ZahinTasnim/PTT_Cuffless_BP_Monitor/docs/workflow_flowchart.png

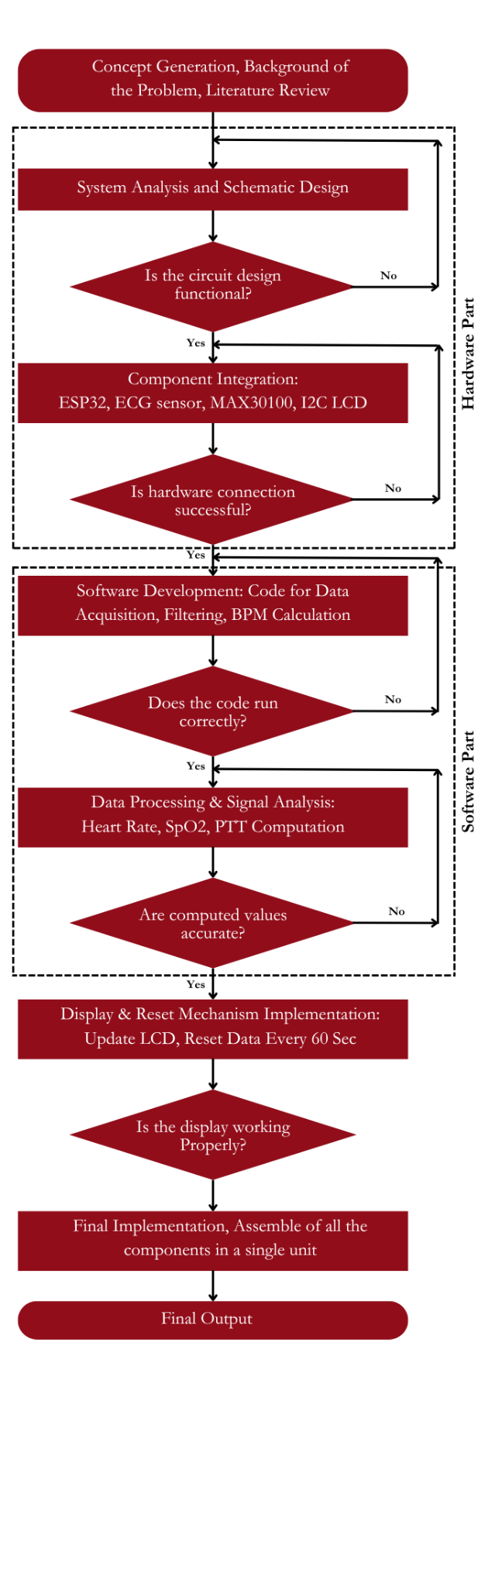
docs/workflow_flowchart.png
