ZahinTasnim/PTT_Cuffless_BP_Monitor/validation/data/subjects_info.csv

record | activity | gender | height | weight | age | bp_sys_start | bp_sys_end | bp_dia_start | bp_dia_end | hr_1_start | hr_1_end | hr_2_start | hr_2_end | spo2_start | spo2_end
s10_run | run | female | 160 | 60 | 25 | 113 | 121 | 69 | 74 | 73 | 93 | 75 | 90 | 96 | 97
s10_walk | walk | female | 160 | 60 | 25 | 121 | 106 | 74 | 69 | 93 | 73 | 90 | 72 | 97 | 95
s10_sit | sit | female | 160 | 60 | 25 | 106 | 98 | 69 | 65 | 73 | 71 | 72 | 69 | 95 | 98
s11_sit | sit | male | 180 | 65 | 30 | 106 | 100 | 73 | 70 | 61 | 64 | 60 | 62 | 97 | 98
s11_walk | walk | male | 180 | 65 | 30 | 100 | 105 | 70 | 72 | 64 | 67 | 62 | 67 | 98 | 98
s11_run | run | male | 180 | 65 | 30 | 105 | 113 | 72 | 75 | 67 | 65 | 67 | 66 | 98 | 96
s12_walk | walk | male | 185 | 80 | 25 | 125 | 119 | 87 | 80 | 81 | 79 | 79 | 79 | 97 | 96
s12_run | run | male | 185 | 80 | 25 | 119 | 129 | 80 | 80 | 79 | 70 | 79 | 76 | 96 | 95
s12_sit | sit | male | 185 | 80 | 25 | 129 | 116 | 80 | 75 | 70 | 72 | 76 | 73 | 95 | 97
s13_walk | walk | male | 175 | 80 | 25 | 134 | 140 | 82 | 84 | 78 | 74 | 76 | 78 | 98 | 98
s13_sit | sit | male | 175 | 80 | 25 | 140 | 125 | 84 | 89 | 74 | 78 | 78 | 78 | 98 | 97
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
