ZahinTasnim/PTT_Cuffless_BP_Monitor/validation/results/loso_predictions_dbp.csv

record | measured | predicted_ptt | predicted_hr
s10_run | 4.50 | 0.55 | 4.61
s10_walk | 4.50 | 1.04 | 2.10
s11_walk | -0.50 | 4.20 | 2.06
s12_run | 2.50 | 0.25 | 3.23
s13_run | 2.50 | 0.40 | 2.53
s13_walk | -3.50 | 1.24 | 1.94
s14_run | 6.50 | 0.79 | 2.45
s14_walk | 3.00 | 2.00 | 1.78
