ZahinTasnim/PTT_Cuffless_BP_Monitor/validation/results/loso_predictions_sbp.csv

record | measured | predicted_ptt | predicted_hr
s10_run | 15.00 | 2.10 | 9.89
s10_walk | 11.50 | 3.98 | 4.50
s11_walk | -0.50 | 13.86 | 5.32
s12_run | 1.50 | 0.87 | 9.28
s13_run | -0.50 | 1.16 | 6.31
s13_walk | 4.50 | 3.63 | 4.83
s14_run | 11.00 | 3.84 | 6.96
s14_walk | 12.00 | 9.65 | 5.07
