ZahinTasnim/PTT_Cuffless_BP_Monitor/validation/results/mean_vs_median_displayed_spread.csv

record | spread_mean_of_8_ms | spread_median_of_8_ms | change_ms
s10_run | 15.8 | 15.0 | -0.8
s10_sit | 19.0 | 18.0 | -1.0
s10_walk | 18.7 | 19.0 | 0.3
s11_sit | 37.0 | 31.0 | -6.0
s11_walk | 57.2 | 39.0 | -18.2
s12_run | 41.6 | 15.0 | -26.6
s12_sit | 8.2 | 8.0 | -0.2
s13_run | 32.6 | 32.0 | -0.6
s13_sit | 35.1 | 36.0 | 0.9
s13_walk | 117.8 | 141.0 | 23.2
s14_run | 25.8 | 29.0 | 3.2
s14_sit | 66.9 | 61.0 | -5.9
s14_walk | 55.1 | 55.0 | -0.1
