ZahinTasnim/PTT_Cuffless_BP_Monitor/validation/results/per_recording.csv

record | subject | activity | minutes | annotated | detected | matched | sensitivity | ppv | timing_offset_median_ms | timing_offset_sd_ms | hr_firmware | hr_annotated | ptt_readings | ptt_median_ms | ptt_iqr_ms | displayed_iqr_ms | displayed_iqr_mean8_ms | ptt_vs_ref_bias_ms | ptt_vs_ref_sd_ms | sbp_start | sbp_end | dbp_start | dbp_end | sbp | dbp | hr_cuff
s10_run | s10 | run | 8.10 | 825 | 825 | 825 | 100.00 | 100.00 | -8.00 | 1.85 | 102.74 | 102.39 | 823 | 308.00 | 24.00 | 15.00 | 15.75 | 7.19 | 1.85 | 113 | 121 | 69 | 74 | 117.00 | 71.50 | 83.00
s10_sit | s10 | sit | 8.10 | 602 | 602 | 602 | 100.00 | 100.00 | -8.00 | 1.43 | 74.26 | 74.26 | 601 | 346.00 | 18.00 | 18.00 | 19.00 | 8.45 | 1.43 | 106 | 98 | 69 | 65 | 102.00 | 67.00 | 72.00
s10_walk | s10 | walk | 8.10 | 706 | 706 | 706 | 100.00 | 100.00 | -8.00 | 1.49 | 87.21 | 87.46 | 666 | 274.00 | 30.00 | 19.00 | 18.69 | 7.50 | 1.49 | 121 | 106 | 74 | 69 | 113.50 | 71.50 | 83.00
s11_sit | s11 | sit | 8.10 | 586 | 586 | 586 | 100.00 | 100.00 | -12.00 | 2.16 | 72.82 | 72.82 | 577 | 410.00 | 34.00 | 31.00 | 37.00 | 12.70 | 2.16 | 106 | 100 | 73 | 70 | 103.00 | 71.50 | 62.50
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
